pdpb-me/home-sensing/(commit log)

2026-10-13 Initial commit: sensor check and e-paper firmware
2026-10-31 Move entrance node to SCD41 and battery, with air quality rating
    Replace the BMP280 with the SCD41 and add battery sensing. Store CO2 and
    battery readings, keeping the pressure history in the table. Show a
    good/fair/poor air rating on the e-paper and dashboard, and simplify the
    e-paper status lines to icons.
    [home_sensor.ino, secrets.example.h]
2026-10-31 Refine e-paper layout: top status strip and humidity status
    Move compact Wi-Fi and battery icons to a top strip and the air advice to
    the bottom edge. Show Dry/OK/Humid on the e-paper and dashboard, and set
    the temperature offset to 2 C against a reference reading.
2026-10-31 Add deep sleep: read every 5 minutes, upload every 30
    Wake from deep sleep to take a single-shot reading and redraw the e-paper,
    uploading in batches or right away when the air turns poor. Stay awake while
    a USB host is connected. Keep the queue in RTC memory, inset the status icons
    for a rounded case, and raise the dashboard's offline limit to 45 minutes.
2026-10-31 Redesign dashboard around a device twin and hourly air history
    Show a copy of the e-paper screen with a list of readings that switches the
    chart, add a square-per-hour view of today's air, and apply the new light-only
    visual language.
2026-10-31 Retry failed uploads sooner and remove the temperature offset
    Try again at the next three readings after a failed upload, then return to
    the regular schedule. Set the offset to 0 C, since self-heating is negligible
    in single-shot mode and the sensor can't take a negative value.
    [home_sensor.ino, secrets.example.h]
